robotfreak/FlipDot/Images/FlipDot-Clock-Back.jpg

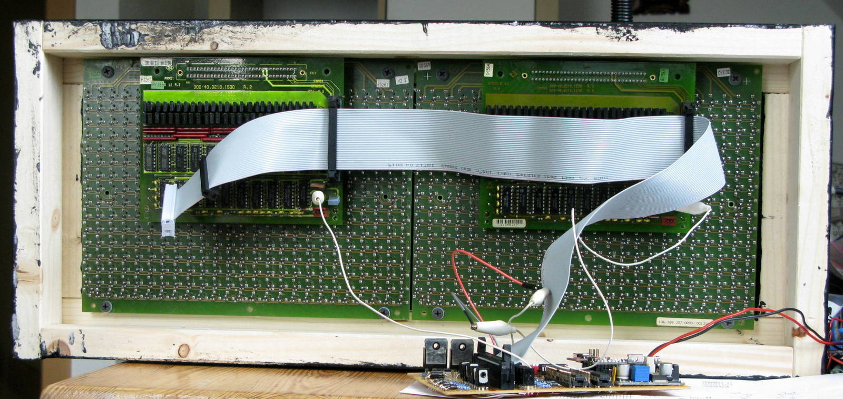
Images/FlipDot-Clock-Back.jpg
