robotfreak/FlipDot/Images/FlipDot-Controller.jpg

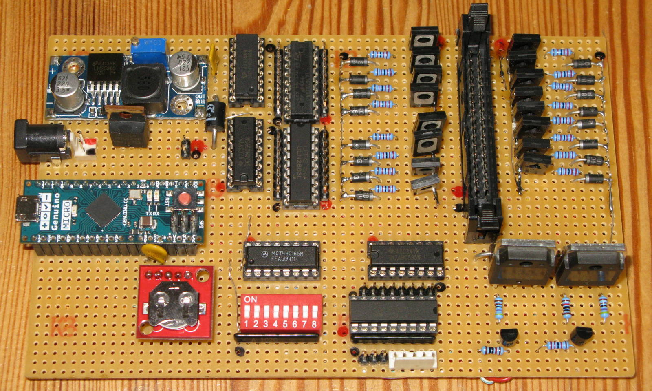
Images/FlipDot-Controller.jpg
