robotfreak/FlipDot/Images/FlipDot-Ctrl1.jpg

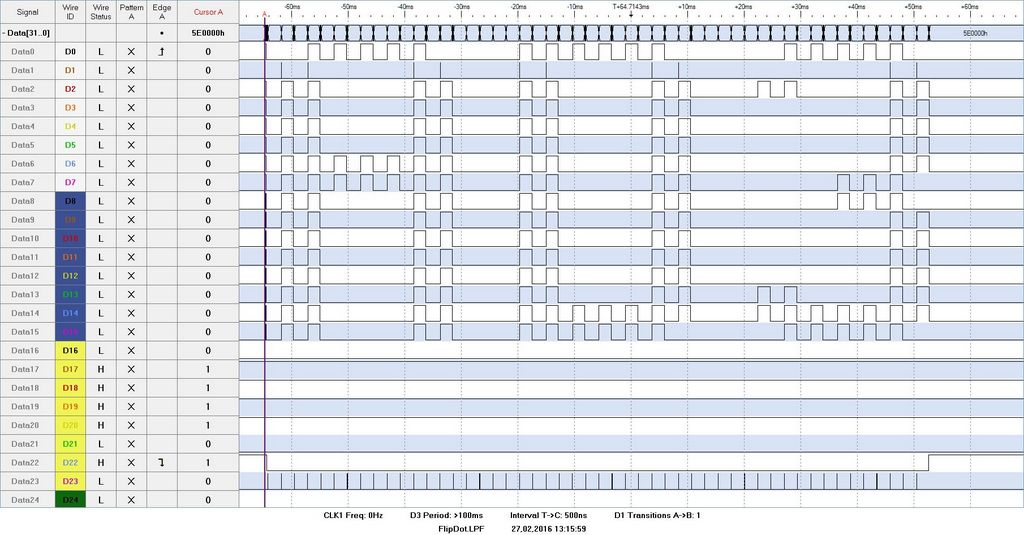
Images/FlipDot-Ctrl1.jpg
