robotfreak/FlipDot/(threads)

Thread 2 (2020-07-09):

Hardware Fragen

MMonu, 2020-07-09:
Sind bei deinen Annax-Flipboards die rechten Kontakte alle miteinander verbunden? Ich sehe nämlich viele Flipdot-Controller, welche sowohl das Reset und Set für jeden Pixel einzeln machen und dafür sowohl die "obere" als auch die "untere" Zeilenansteuerung individuell adressierbar haben. Oder hab ich die Funktionsweise einfach vollkommen missverstanden?

robotfreak, 2020-07-15:
Beim Annax Flipdot kann man keine einzelnen Pixel ansteuern, immer nur das komplette Panel. Auf dem Panel sitzt das Spaltentreiber Modul. Das Controller Modul schiebt parallel auf alle 16 Zeilen die Pixel an/aus Informationen raus.
Siehe https://github.com/robotfreak/FlipDot/blob/master/Images/FlipDot-Ctrl1.jpg

Closed 2020-08-17.
