robotfreak/FlipDot/Schematics/flipdot-schematic-v1-4.pdf

# Arduino

+3V

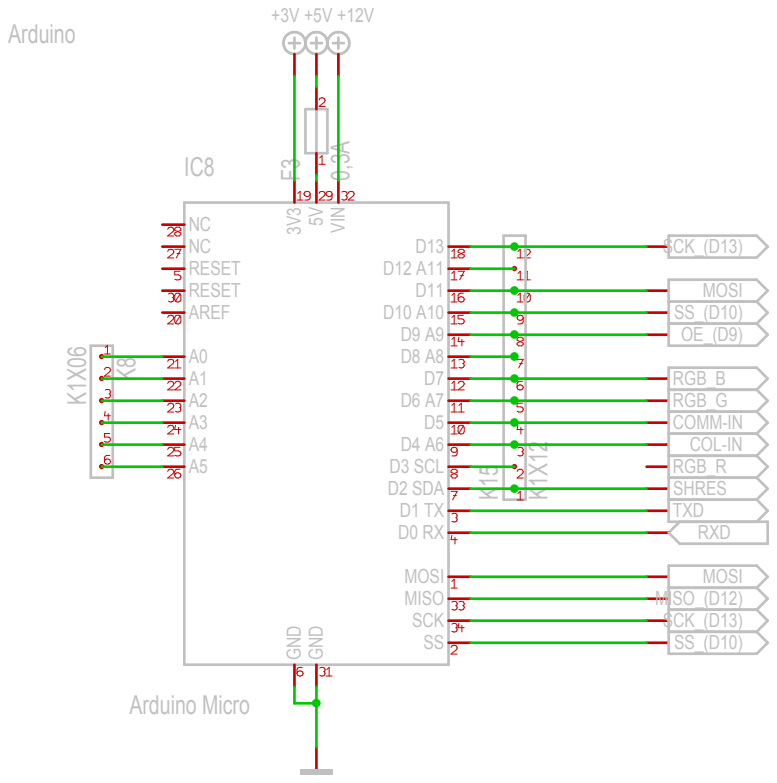
[picture p6: page 1]

# Connectors

K4

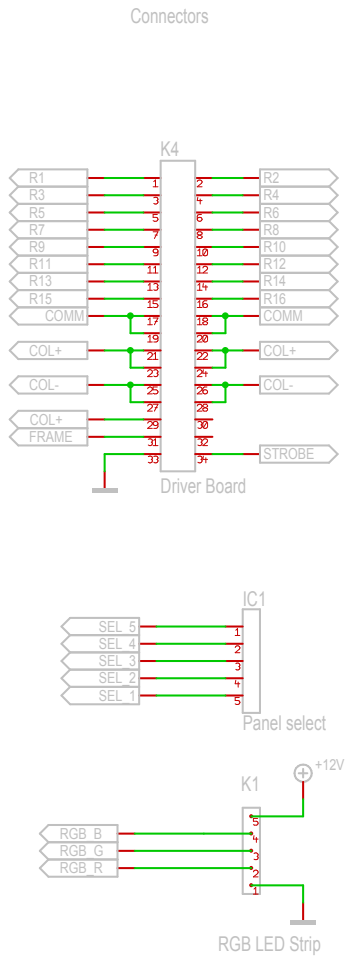
[picture p7: page 2]

# 24V-Driver

## VCC_1

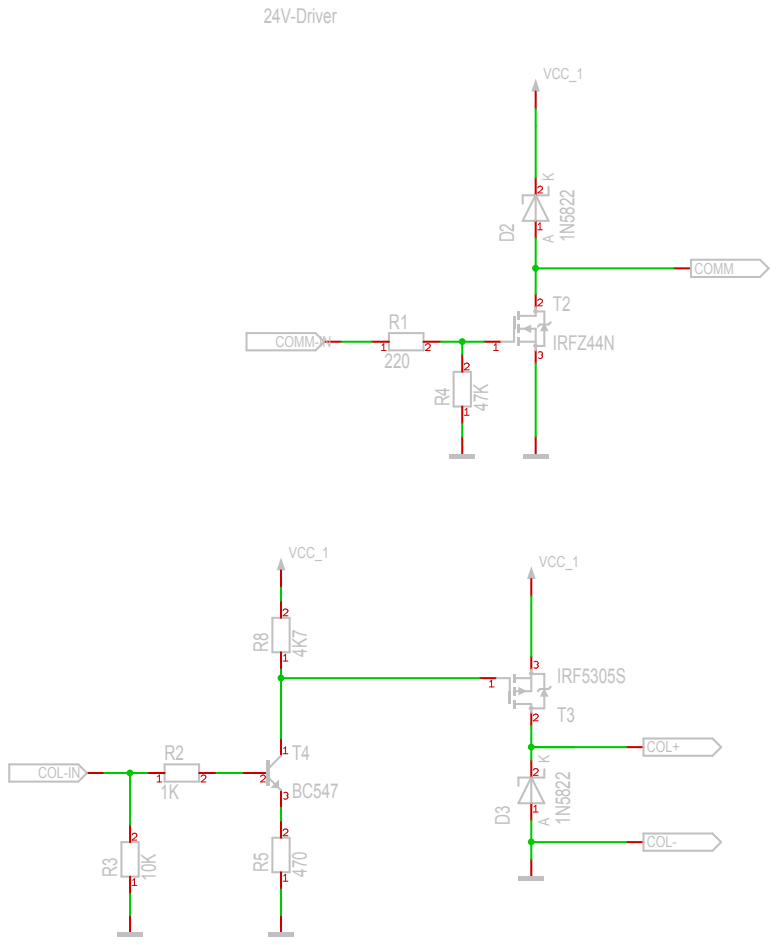
[picture p8: page 3]

### Shiftregister

IC16

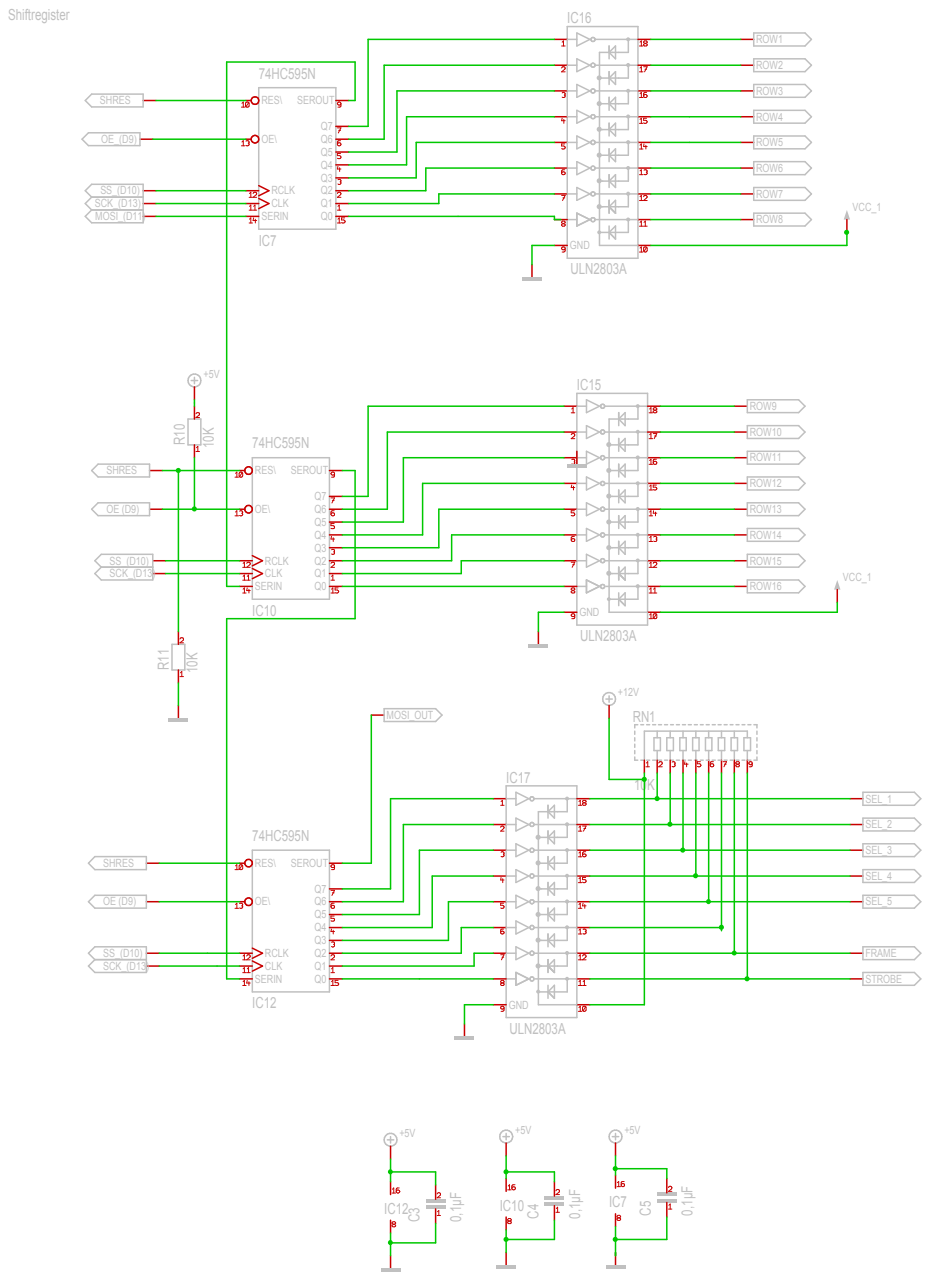
[picture p9: page 4]

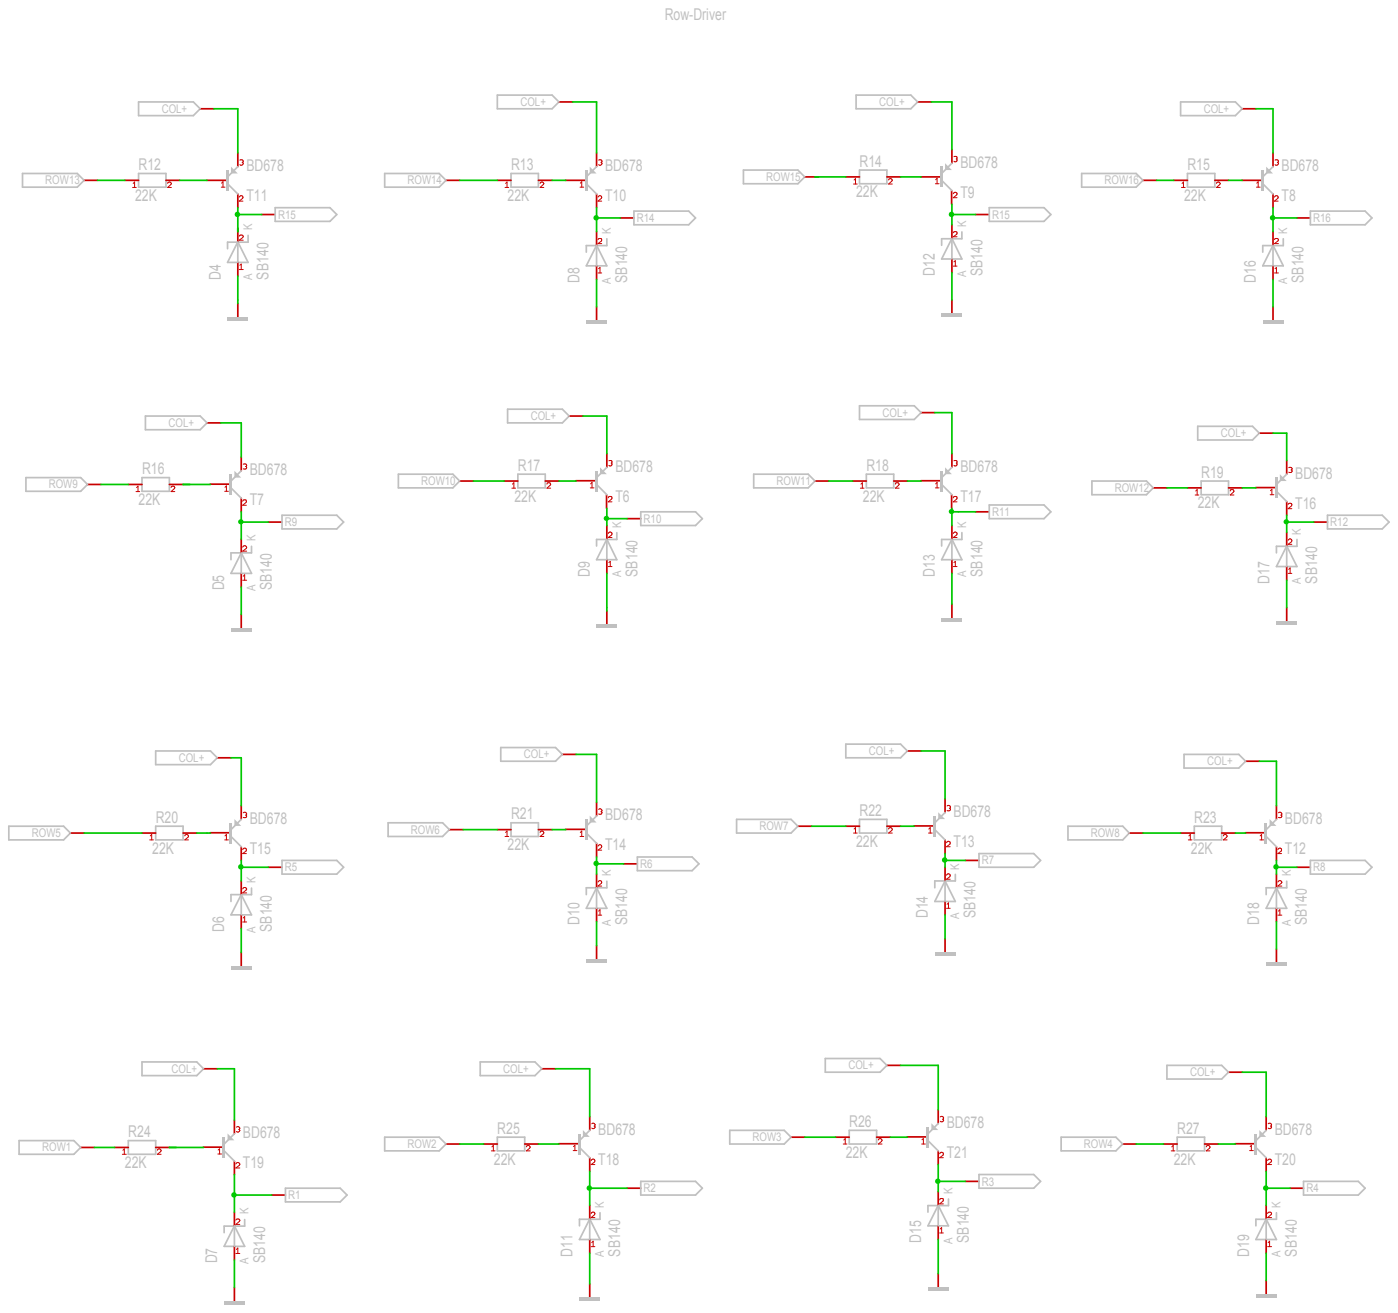
[picture p10: page 5]

## Power

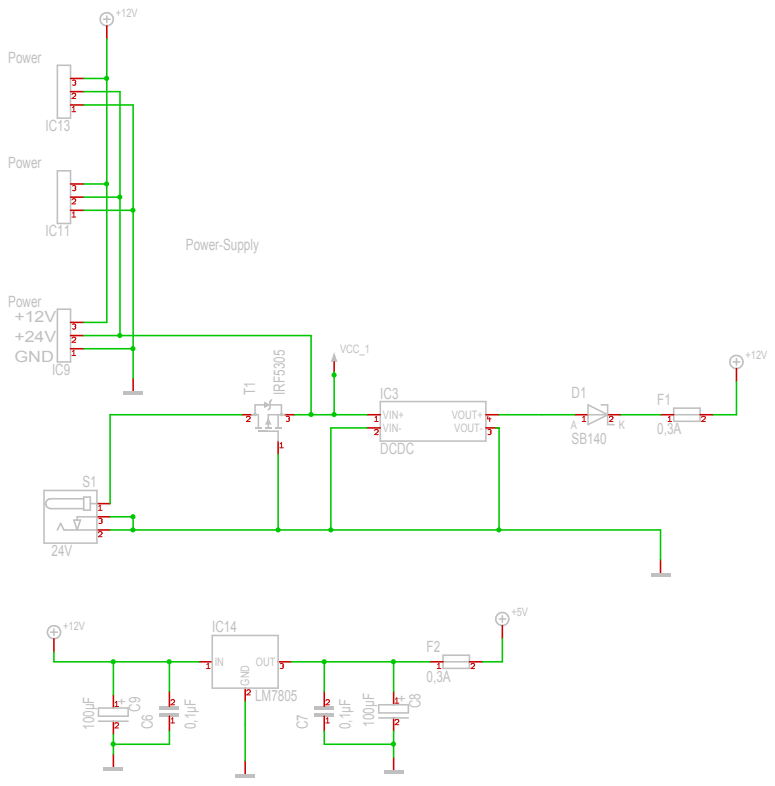
[picture p11: page 6]
