robotfreak/FlipDot/Schematics/flipdot-schematic-v1-3.pdf

# Arduino

+3V

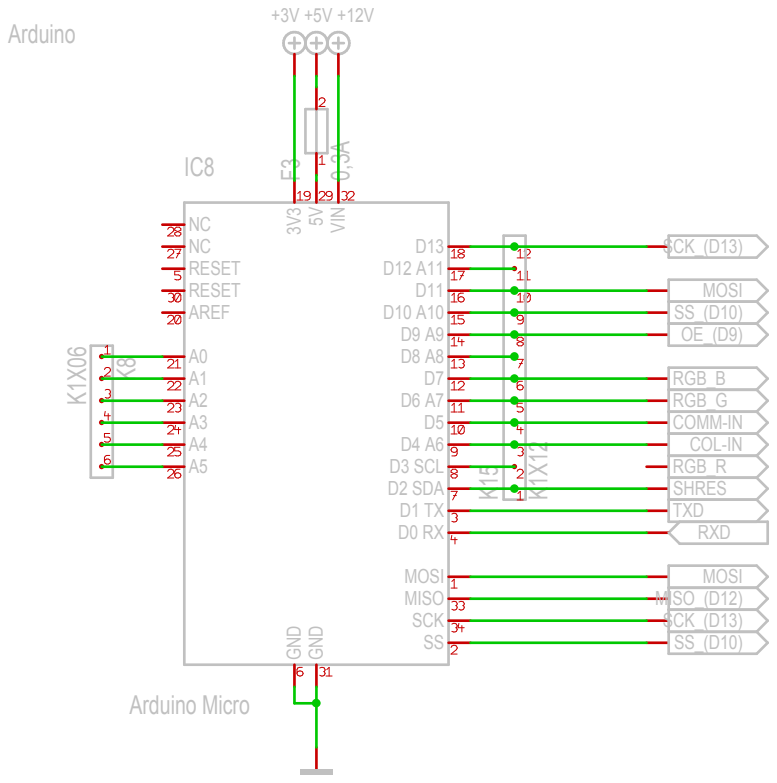
[picture p12: page 1]

### Shiftregister

IC4

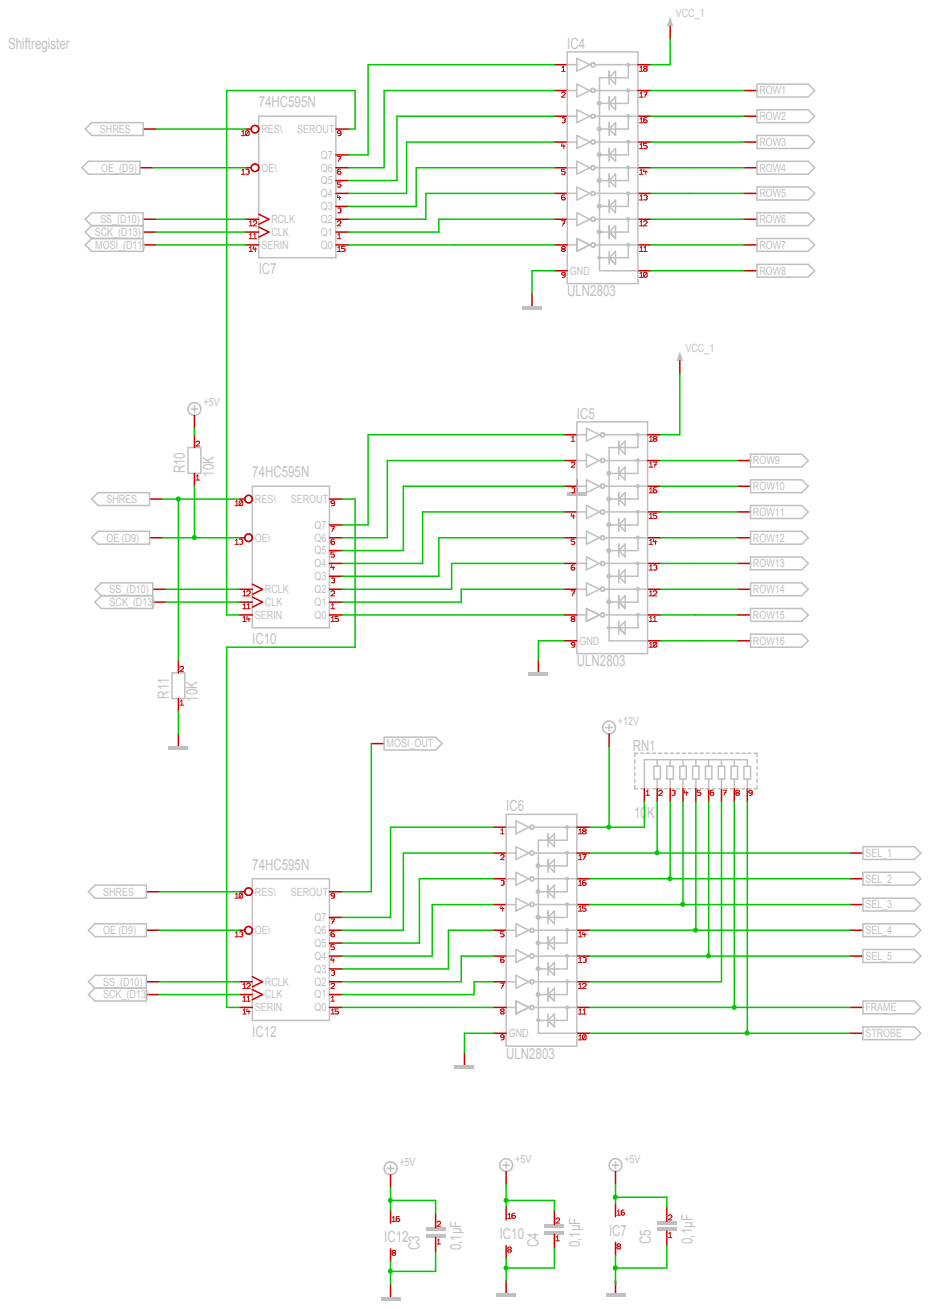
[picture p13: page 2]


# 24V-Driver

## COL+

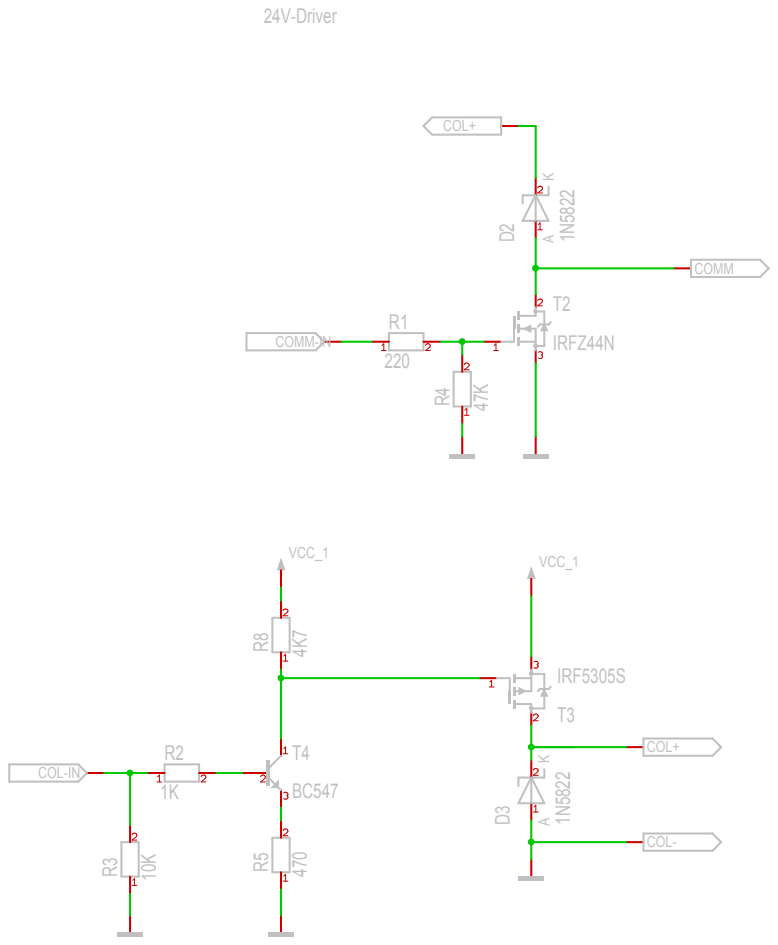
[picture p14: page 4]

## Power

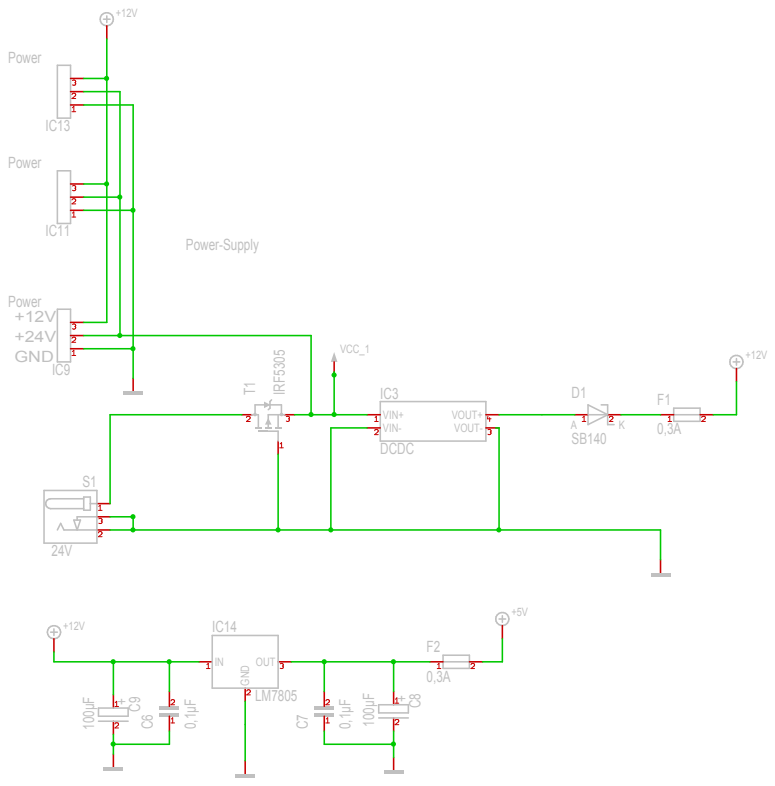
[picture p15: page 5]

# Connectors

K4

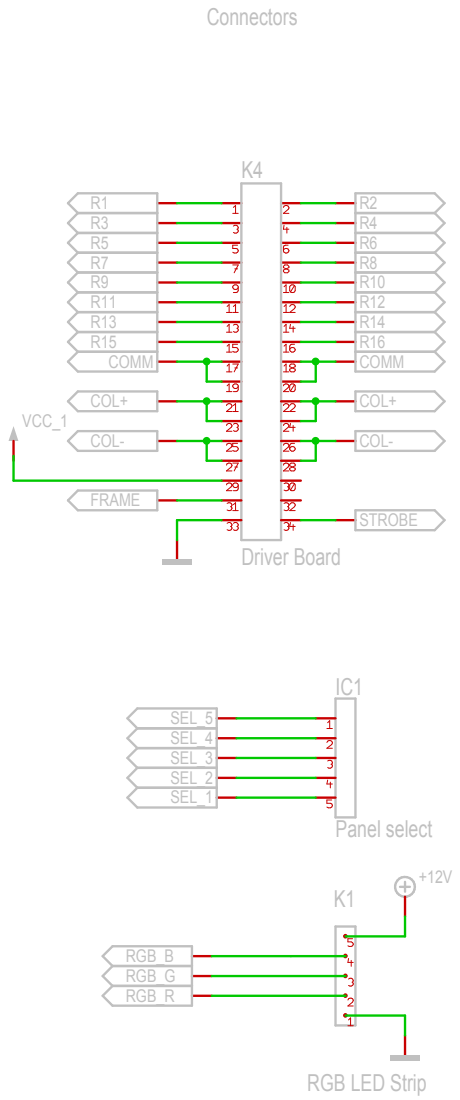
[picture p16: page 6]
