robotfreak/FlipDot/Schematics/flipdot-schematic-v1-0.pdf

# Arduino

# COL-IN

# SHRES

# RXD

# TXD

# RESET

# MISO_(D12)

# CE_(D8)

# LOAD_(D7)

# OE_(D9) SS_(D10)

# SCK_(D13)

# MOSI MISO_(D12)

+12V

+5V

34 | IO13*
33 | 3V3
32 | AREF
31 | A0
30 | A1
29 | A2
28 | A3
27 | A4
26 | A5

25

24

23 | +5V
22 | RESET
21 | GND
20 | VIN
19 | MISO
18 | SCK

# Arduino_Micro_Shield

X1b

17 | IO12*
16 | IO11*
15 | IO10*
14 | IO9*
13 | IO8
12 | D7
11 | D6*
10 | D5*
9 | D4*
8 | D3/SCL
7 | D2/SDA
6 | GND
5 | RESET
4 | D0/RX
3 | D1/TX
2 | RXLED/SS
1 | MOSI

# Arduino_Micro_Shield

X1a

## ULN2803

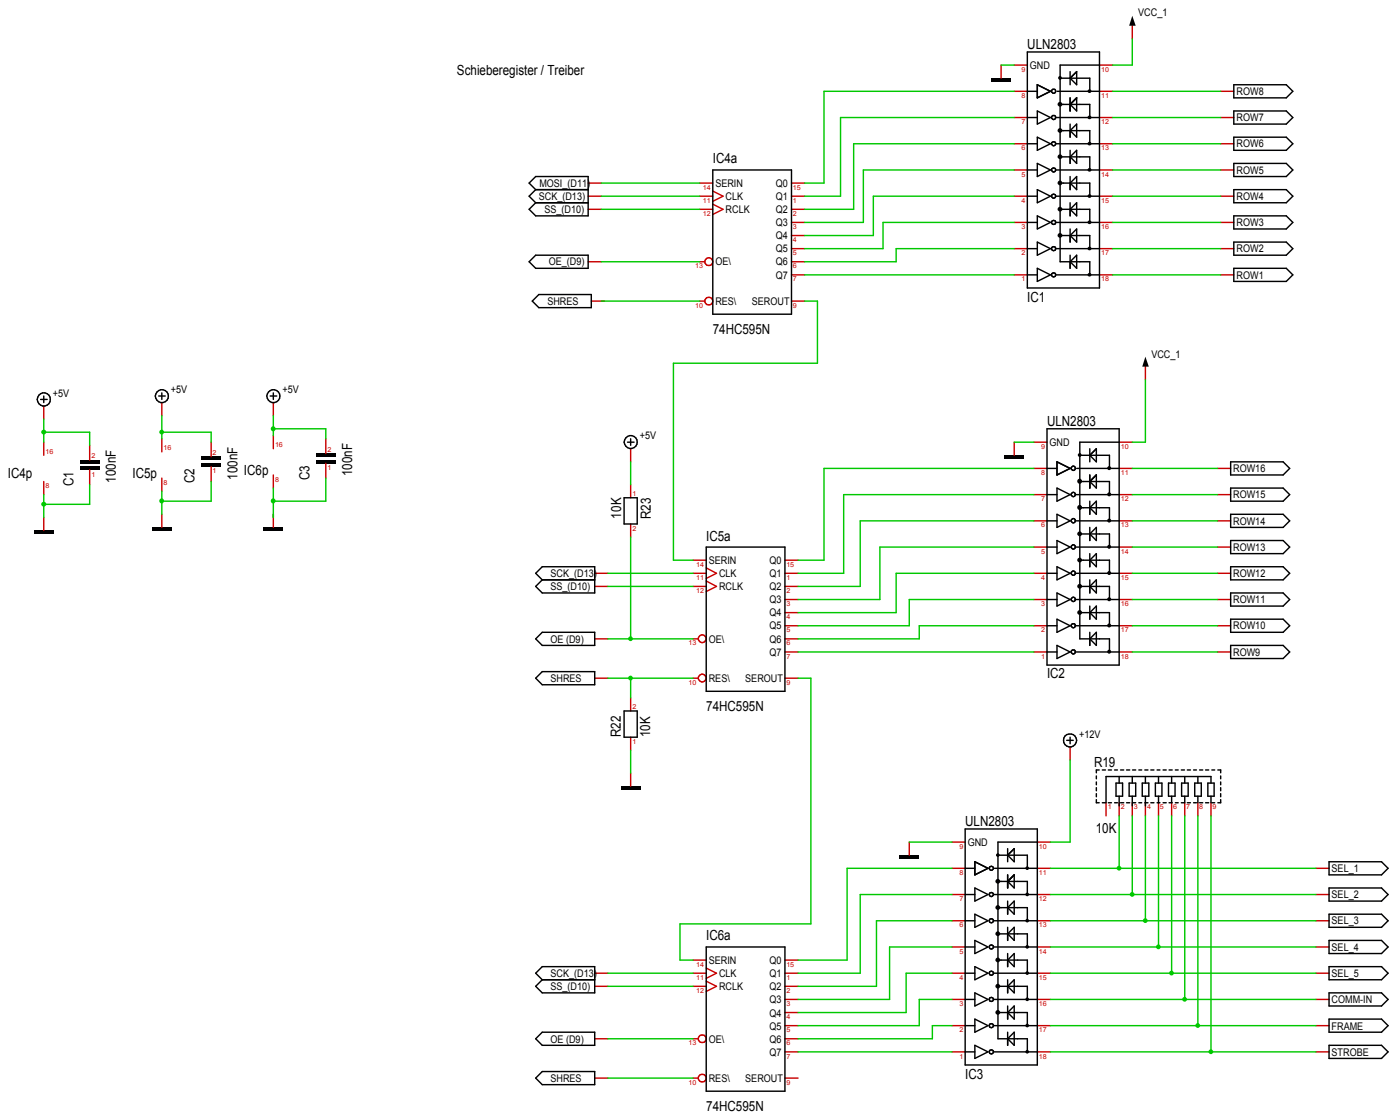
[picture p22: page 2]

# DIP Schalter

+5V

2

1

C4

100nF

16

8

# IC7p

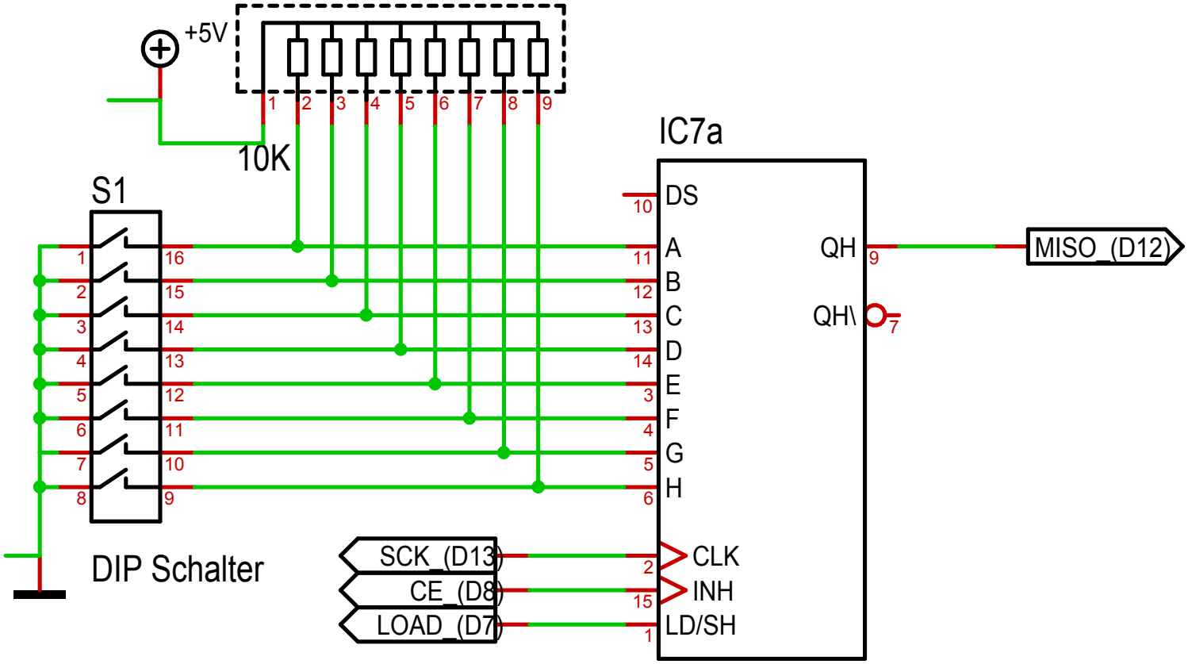
[picture p23: figure]
SCK_(D13); LOAD_(D7); MISO_(D12); INH; CLK; DIP Schalter

# 74HC165N

R20

# COMM/COL Treiber

+12V | +12V

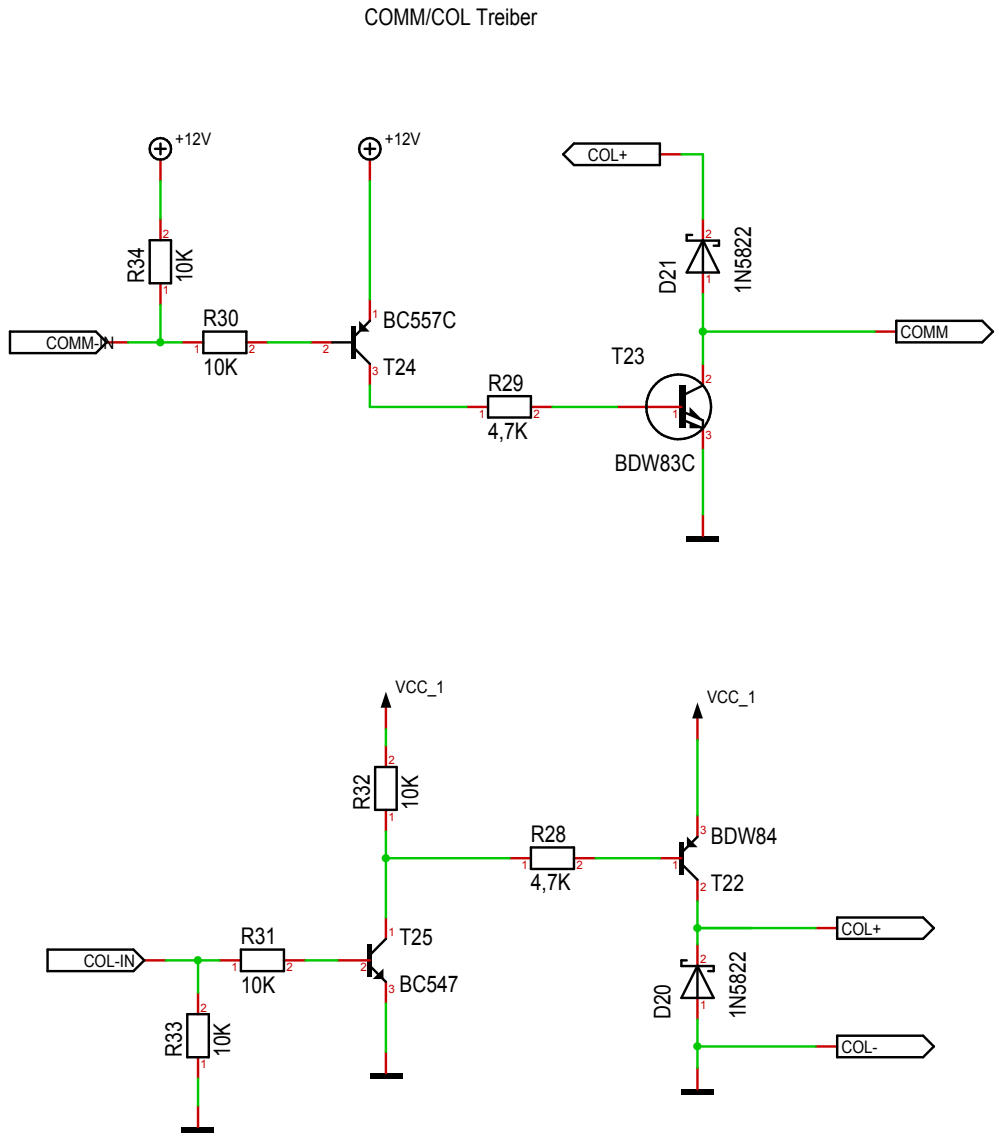
[picture p24: page 4]

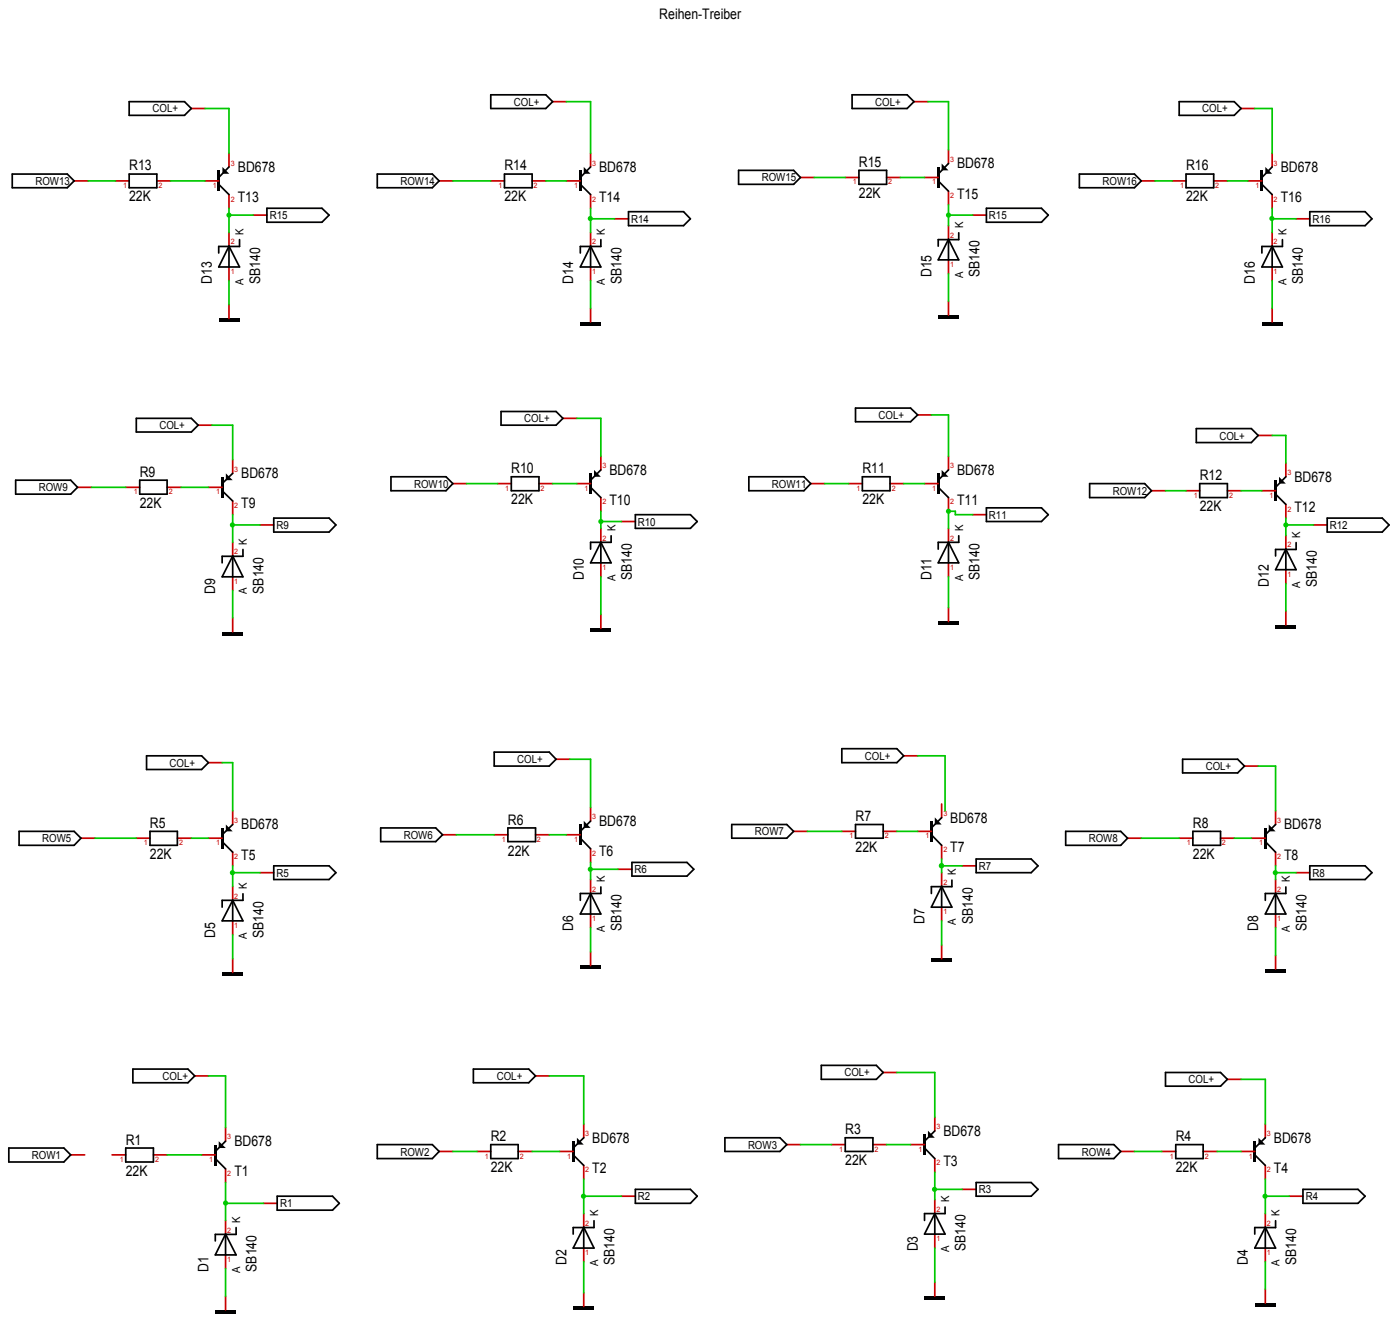
[picture p25: page 5]

# Steckverbinder

+5V

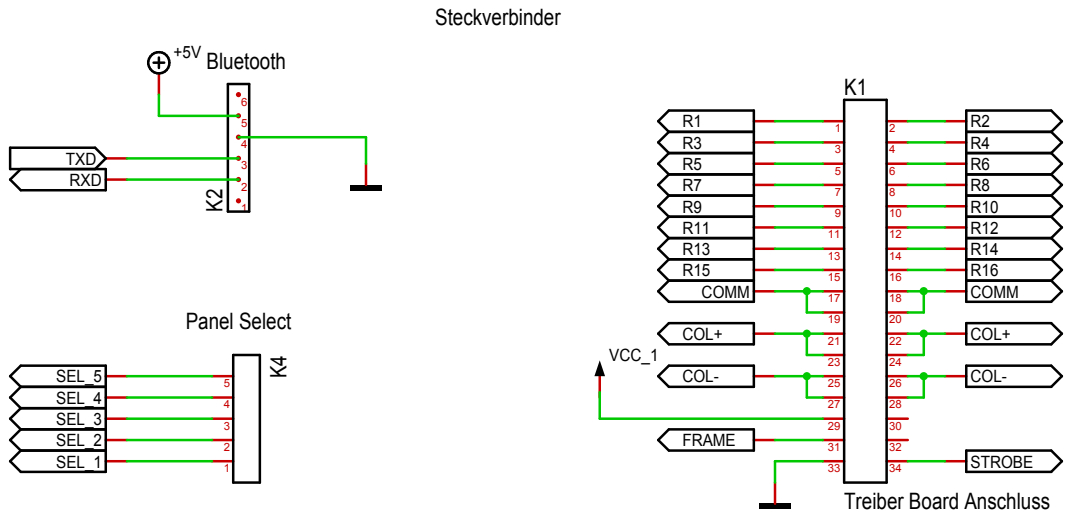
[picture p26: page 6]

# Stromversorgung

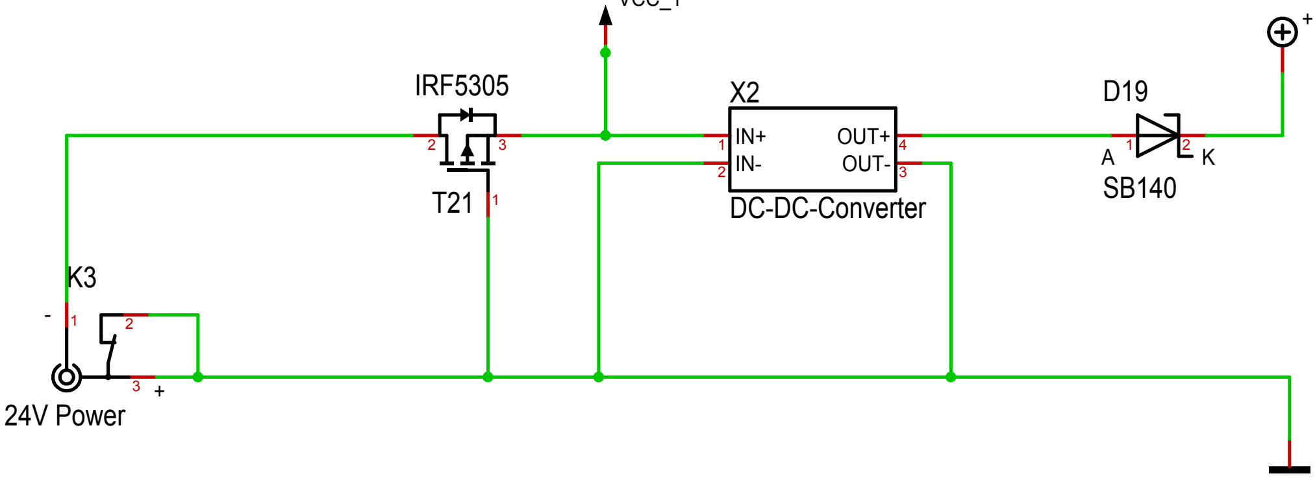
[picture p27: figure]
OUT-; OUT+; DC-DC-Converter; IRF5305; 24V Power

+12V

# VCC_1
