robotfreak/FlipDot/Arduino/AnnaxFlipdot/Flipdot.h

#ifndef __FLIPDOT_H__
#define __FLIPDOT_H__

#if defined(ARDUINO) && ARDUINO >= 100
#include "Arduino.h"
#else
#include "WProgram.h"
#endif 
#include <Adafruit_GFX.h> 
#include "fonts/f5x7font5pt7b.h"

const byte LATCH = 10;
const byte OE = 9;
const byte COMM = 5;
const byte COL = 4;

#define SET 1
#define RESET 0
#define OFF 0
#define ON 1

#define YELLOW 1
#define BLACK 0

#define XSMALL 0
#define SMALL 1
#define MEDIUM 2
#define LARGE 3
#define XLARGE 4

#define FLIPDOT_BLACK          0
#define FLIPDOT_YELLOW         1  
//#define FD_COLUMS 50
//#define FD_PANELS 2 
#define FD_COLUMS 115
#define FD_ROWS 16
#define FD_PANELS 5 
#define FD_PANEL_MASK 0xF8
#define FD_PANEL5_SIG 7
#define FD_PANEL4_SIG 6
#define FD_PANEL3_SIG 5
#define FD_PANEL2_SIG 4
#define FD_PANEL1_SIG 3
//#define FD_COLUMN_SIG 2
#define FD_FRAME_SIG 1
#define FD_STROBE_SIG 0

class FlipDotUtils;

class FlipDot : public Adafruit_GFX {
  public: 
    //FlipDot();
    FlipDot(int16_t x, int16_t y);
    void begin(int8_t latch, int8_t oe, int8_t col, int8_t comm);
    void begin(void);
    void setOnTime(int time);
    void setPanels(int16_t cnt);
    void drawPixel(int16_t, int16_t, uint16_t); 
    void set(int16_t x, int16_t y, uint16_t color);
    void setColumn(uint8_t x, uint16_t y, uint8_t dat);

    void update(void);
    void updatePanel(int panel);
    
  private:
    byte bitReverse(byte x);
    void ShiftOut(void);
    
//    byte fdPanelSize[FD_PANELS] = {25, 25}; //, 20, 20, 25};
//    byte fdPanelSelect[FD_PANELS] = {FD_PANEL1_SIG, FD_PANEL2_SIG}; //, FD_PANEL3_SIG, FD_PANEL4_SIG, FD_PANEL5_SIG};
    byte fdPanelSize[FD_PANELS] = {25, 25, 20, 20, 25};
    byte fdPanelSelect[FD_PANELS] = {FD_PANEL1_SIG, FD_PANEL2_SIG, FD_PANEL3_SIG, FD_PANEL4_SIG, FD_PANEL5_SIG};
    boolean *displayBuffer = NULL;
 
    byte fdMtx[2][FD_COLUMS];
    byte updPanel[FD_PANELS];

    byte fdRow1, fdRow2, fdCtrl;
 
    int latchPin, oePin, resPin, colPin, comPin;
//    int redPin, greenPin, bluePin;
    int sizeX, sizeY;
    int panels;
    int onTime;
};

#endif /* __FLIPDOT_H__ */
