robotfreak/FlipDot/Python/FlipDotCtrl/fiveBySevenFont.py

# Converted to Python format from the C version at http://www.eran.io/the-dot-factory-an-lcd-font-and-image-generator/
fiveBySevenCharBitmaps = """
	00000000, #         
	00000000, #         
	01011111, #  # #####
	00000000, #         
	00000000, #         

	00000000, #         
	00000111, #      ###
	00000000, #         
	00000111, #      ###
	00000000, #         

	00010100, #    # #  
	01111111, #  #######
	00010100, #    # #  
	01111111, #  #######
	00010100, #    # #  

	00100100, #   #  #  
	00101010, #   # # # 
	01111111, #  #######
	00101010, #   # # # 
	00010010, #    #  # 

	00100011, #   #   ##
	00010011, #    #  ##
	00001000, #     #   
	01100100, #  ##  #  
	01100010, #  ##   # 

	00110110, #   ## ## 
	01001001, #  #  #  #
	01010101, #  # # # #
	00100010, #   #   # 
	01010000, #  # #    

	00000000, #         
	00000101, #      # #
	00000011, #       ##
	00000000, #         
	00000000, #         

	00000000, #         
	00011100, #    ###  
	00100010, #   #   # 
	01000001, #  #     #
	00000000, #         

	00000000, #         
	01000001, #  #     #
	00100010, #   #   # 
	00011100, #    ###  
	00000000, #         

	00001000, #     #   
	00101010, #   # # # 
	00011100, #    ###  
	00101010, #   # # # 
	00001000, #     #   

	00001000, #     #   
	00001000, #     #   
	00111110, #   ##### 
	00001000, #     #   
	00001000, #     #   

	00000000, #         
	01010000, #  # #    
	00110000, #   ##    
	00000000, #         
	00000000, #         

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
	00011000, #    ##   
	00000100, #      #  
	01111000, #  ####   

	01111100, #  #####  
	00001000, #     #   
	00000100, #      #  
	00000100, #      #  
	01111000, #  ####   

	00111000, #   ###   
	01000100, #  #   #  
	01000100, #  #   #  
	01000100, #  #   #  
	00111000, #   ###   

	01111100, #  #####  
	00010100, #    # #  
	00010100, #    # #  
	00010100, #    # #  
	00001000, #     #   

	00001000, #     #   
	00010100, #    # #  
	00010100, #    # #  
	00011000, #    ##   
	01111100, #  #####  

	01111100, #  #####  
	00001000, #     #   
	00000100, #      #  
	00000100, #      #  
	00001000, #     #   

	01001000, #  #  #   
	01010100, #  # # #  
	01010100, #  # # #  
	01010100, #  # # #  
	00100000, #   #     

	00000100, #      #  
	00111111, #   ######
	01000100, #  #   #  
	01000000, #  #      
	00100000, #   #     

	00111100, #   ####  
	01000000, #  #      
	01000000, #  #      
	00100000, #   #     
	01111100, #  #####  

	00011100, #    ###  
	00100000, #   #     
	01000000, #  #      
	00100000, #   #     
	00011100, #    ###  

	00111100, #   ####  
	01000000, #  #      
	00110000, #   ##    
	01000000, #  #      
	00111100, #   ####  

	01000100, #  #   #  
	00101000, #   # #   
	00010000, #    #    
	00101000, #   # #   
	01000100, #  #   #  

	00001100, #     ##  
	01010000, #  # #    
	01010000, #  # #    
	01010000, #  # #    
	00111100, #   ####  

	01000100, #  #   #  
	01100100, #  ##  #  
	01010100, #  # # #  
	01001100, #  #  ##  
	01000100, #  #   #  

	00000000, #         
	00001000, #     #   
	00110110, #   ## ## 
	01000001, #  #     #
	00000000, #         

	00000000, #         
	00000000, #         
	01111111, #  #######
	00000000, #         
	00000000, #         

	00000000, #         
	01000001, #  #     #
	00110110, #   ## ## 
	00001000, #     #   
	00000000, #         

	00000000, #
	00000000, #
	00000000, #
	00000000, #
	00000000, #
"""

charlist = ["!", "\"", "#", "$", "%", "&", "'", "(", ")", "*", "+", ",", "-", ".", "/",
"0", "1", "2", "3", "4", "5", "6", "7", "8", "9", ":", ";", "<", "=", ">", "?", "@", 
"A", "B", "C", "D", "E", "F", "G", "H", "I", "J", "K", "L", "M", "N", "O", "P", "Q", "R", 
"S", "T", "U", "V", "W", "X", "Y", "Z", "[", "\\", "]", "^", "_", "`",
"a", "b", "c", "d", "e", "f", "g", "h", "i", "j", "k", "l", "m", "n", "o", "p", "q", "r",
"s", "t", "u", "v", "w", "x", "y", "z", "{", "|", "}", " "]

# Split to binary strings * 5
binlist = []
for line in fiveBySevenCharBitmaps.splitlines():
	line = line.strip()
	x = line.split(',')
	if not x[0]:continue
	binlist.append(x[0])

def getBinaryFromChar(c):
	fivebinlist = []
	pos = charlist.index(c)
	if (pos > 0): pos = pos * 5
	fivebinlist.append(binlist[pos])
	fivebinlist.append(binlist[pos + 1])
	fivebinlist.append(binlist[pos + 2])
	fivebinlist.append(binlist[pos + 3])
	fivebinlist.append(binlist[pos + 4])
	return fivebinlist
