robotfreak/FlipDot/(commit log)

2016-05-24 FlipDotClock Arduino sketch added
    [FlipDotClockRTCTemp.ino]
2016-05-30 Schematics added, Arduino code moved
2016-06-01 added BOM
2016-10-23 Flipdot Controller Schematic V1
2016-11-27 added reset and column pin
    [FlipDotU8GSerial.ino]
2016-12-08 Flipdot Contgroller, Simulation, Schematic v1.1
    [Flipdot.cpp, Flipdot.h]
2016-12-08 Flipdot Controller PCB v1.1
2016-12-10 older schematic revisio s
2016-12-10 FlipdotControl added Fonts 6x8v, 9x16v. + Bitmap
    [Flipdot.cpp, Flipdot.h]
2016-12-19 Flipdot Control minor bugfixes. Works so far
    [Flipdot.cpp, Flipdot.h, GameOfLife.ino]
2016-12-27 Bugfixes: Bitmap not drawing. Clear Bits when overwrite Framebuffer
    [Flipdot.cpp]
2017-02-16 Flipdot Test updated to new schematic
    [FlipDotTest.ino]
2017-02-16 Flipdot Test changed for new schematic
2017-02-16 slow down SPI transfer rate
2017-02-17 FlipdotCtrl for 5 Panels
    [Flipdot.cpp, Flipdot.h]
2017-02-20 Flipdot NodeMCU Control via Telnet
    [Flipdot.cpp, FlipdotCtrlNodeMCU.ino]
2017-03-03 Layout change
    SHRES Pin 6 -> 2,
    Comm Signal from shift reg. to seperate Pin 5
    COL 24V signal switched on before flipdot update
    [Flipdot.cpp, Flipdot.h]
2017-03-05 New Schematic v1.3
2017-03-05 Added LED Strip support, font9x16a, Pin change for v1.3
2017-03-06 added RGB LED commands
2017-03-06 Revert "added RGB LED commands"
    This reverts commit bb1101eb587e118017cea849651f160f91ce4b56.
    [textdot.py]
2017-05-05 eLab firmware with RGB LED, Serial LCD
2017-05-30 Flipdot Twitter sketch added
    [Flipdot.cpp, Flipdot.h, FlipdotTwitter.ino]
2019-05-15 Flipdot Makerfaire Berlin 2019
    [Flipdot.cpp, Flipdot.h, FlipdotMakerfaire.ino]
2019-06-10 Flipdot Control v1.4 fixed schematic errors
2019-06-10 schematics v1.4
2019-06-13 Control Board images added
2019-06-19 Refactoring Codebase, Arduino Library WIP
2019-06-20 flipdot clock example working
    [FlipDotClockRTCTemp.ino]
2019-06-24 Flipdot Tetris GFX example
    [FlipDotTetrisGFX.ino]
2019-06-26 Adjustable Flipdot on time for speed up display
    [Flipdot.cpp, Flipdot.h, FlipdotUtils.cpp]
2021-11-27 Flipdot for ESP32
